andykarpov/karabas-esplay/docs/karabas-esplay-revA-bottom.png

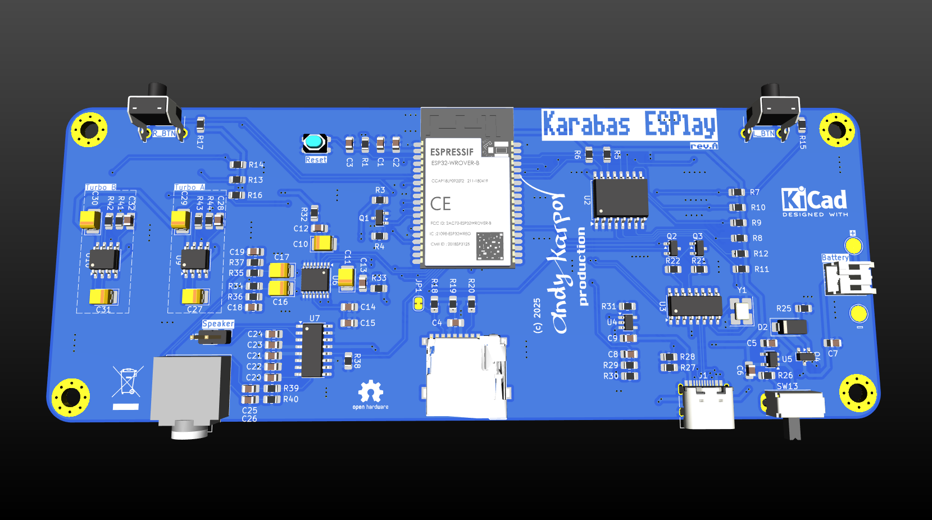
docs/karabas-esplay-revA-bottom.png
