andykarpov/karabas-esplay/README.md

# Karabas ESPlay

A derivative pcb for the ESPlay micro project.

## Key differences:

- A bigger 3.2" ILI9341 display
- Silicone buttons
- Turbo buttons (C and D)

## Credits and license

This board is derived from [ESPlay micro](https://github.com/pebri86/esplay_micro_hardware) by Fuji Pebri. That repository has no license file, but its author [states](https://github.com/pebri86/esplay_micro_hardware/issues/8) that the project is open source and free to modify and build upon, and asks to share modified versions.

The changes made in this repository are released under the MIT License, see [LICENSE](LICENSE). Rights in the original design remain with its author.
