andykarpov/karabas-esplay/docs/karabas-esplay-revA-top.png

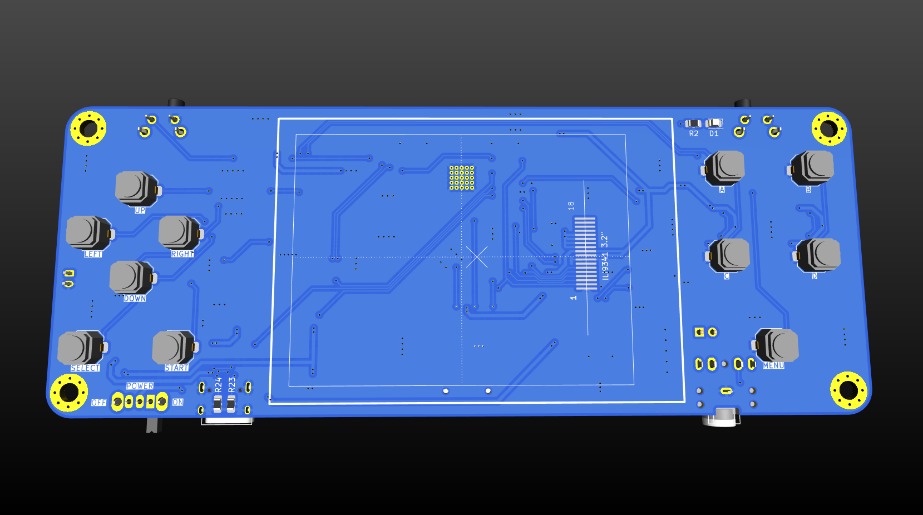
docs/karabas-esplay-revA-top.png
