andykarpov/karabas-esplay/docs/karabas-esplay-revA.pdf

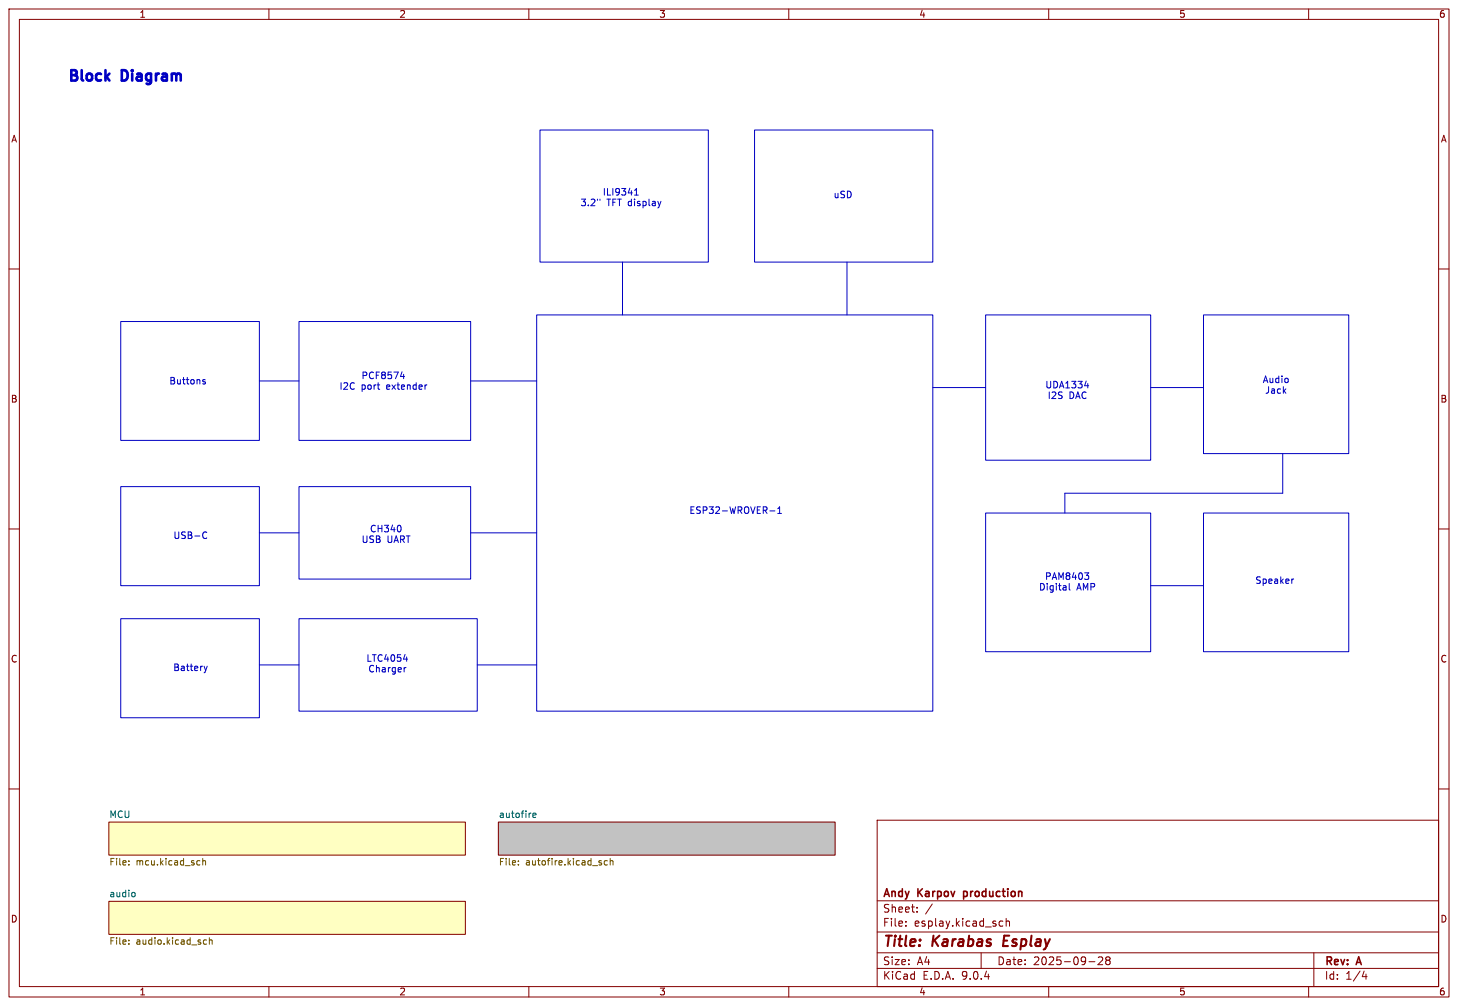
[picture p3: page 1]

audio File: audio.kicad_sch MCU

Id: 1/4 Title: Karabas Esplay

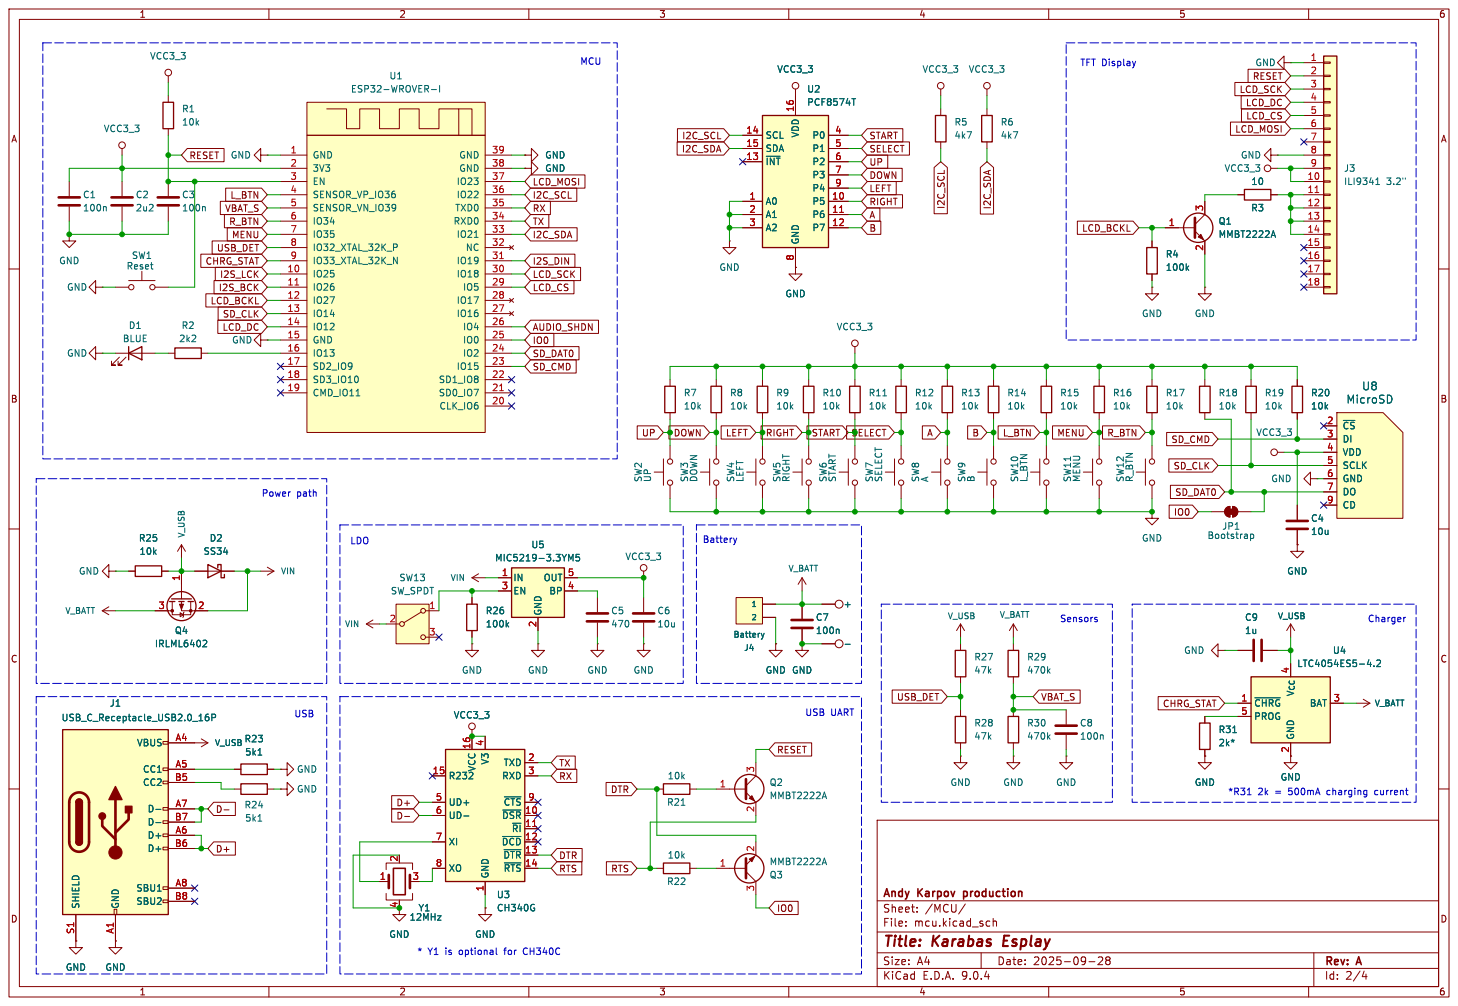
[picture p4: page 2]

~{CS} 2 DI 3 VDD 4 SCLK 5 GND 6 DO 7 CD 9U4

2 OUT 5 BP 4 U5 MIC5219-3.3YM5 GND GND

1 TXD 2 RXD 3 ~{CTS}9 ~{DSR} 10 ~{RI} 11 ~{DCD} 12 ~{DTR} 13 ~{RTS} 14 VCC3_3

1 TXD 2 RXD 3 ~{CTS}9 ~{DSR} 10 ~{RI} 11 ~{DCD} 12 ~{DTR} 13 ~{RTS} 14 U3 CH340G

Id: 2/4 Title: Karabas Esplay

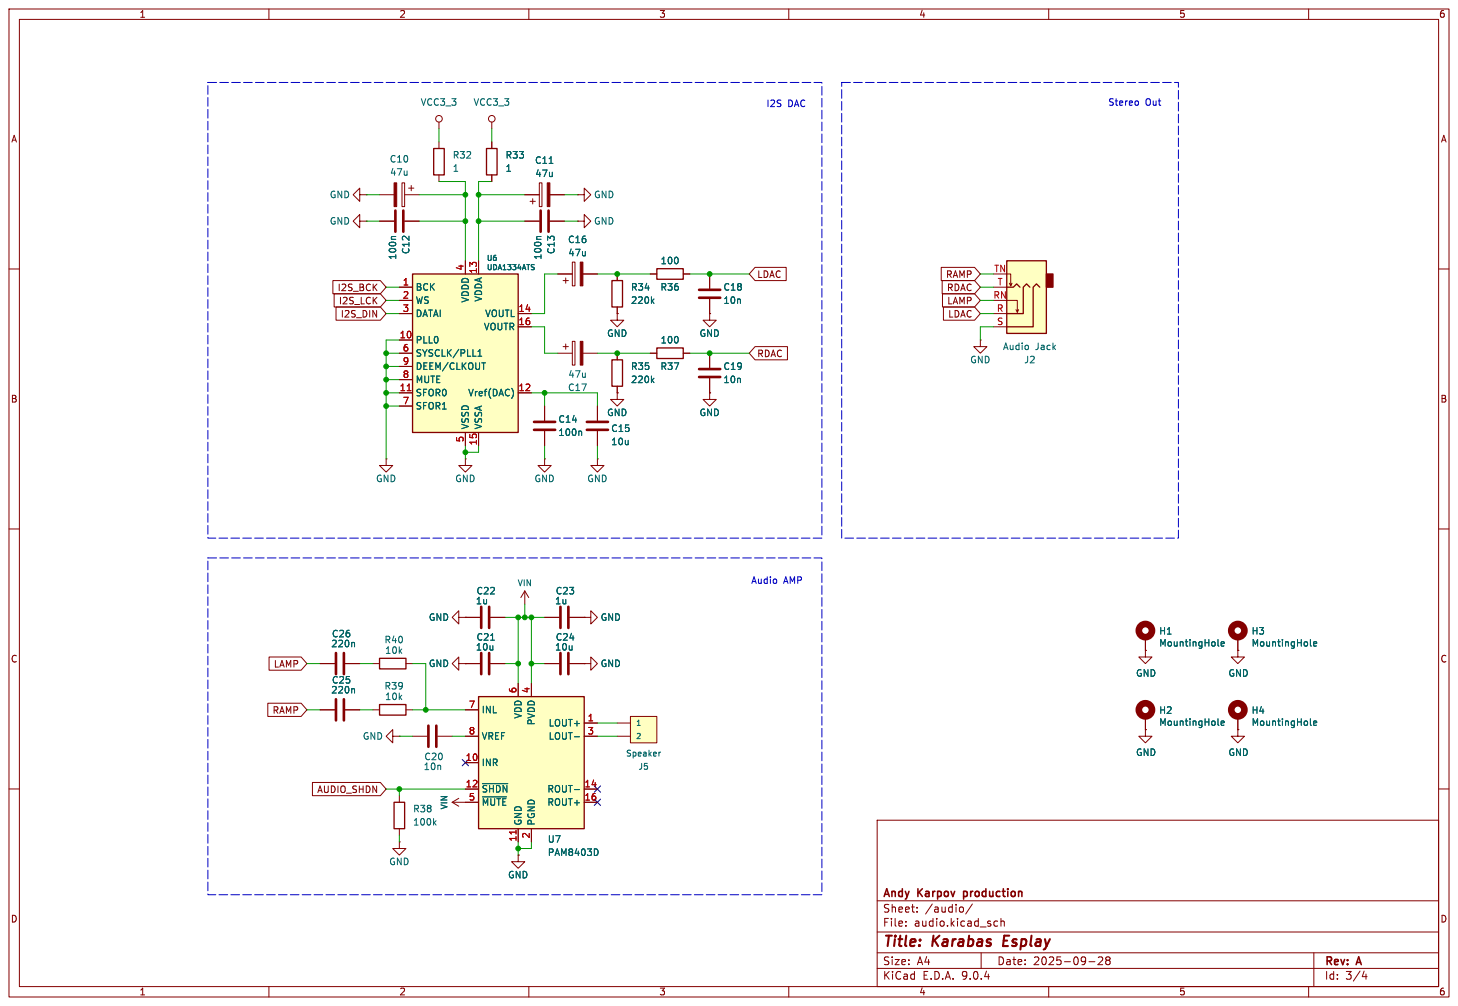
[picture p5: page 3]

5 VDDA 13 VSSA 15 VOUTL 14 VOUTR 16 Vref(DAC) 12 U6 UDA1334ATS GND GND GND

5 VDDA 13 VSSA 15 VOUTL 14 VOUTR 16 Vref(DAC) 12 C15

Id: 3/4 Title: Karabas Esplay

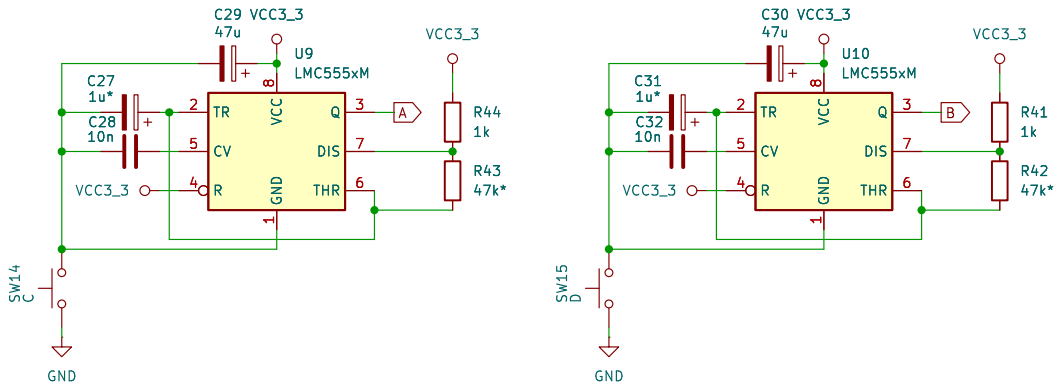
[picture p6: page 4]

Id: 4/4 Title: Karabas Esplay
