andykarpov/karabas-esplay/esplay.kicad_pcb

## KiCad design esplay.kicad_pcb (2025-10-04)

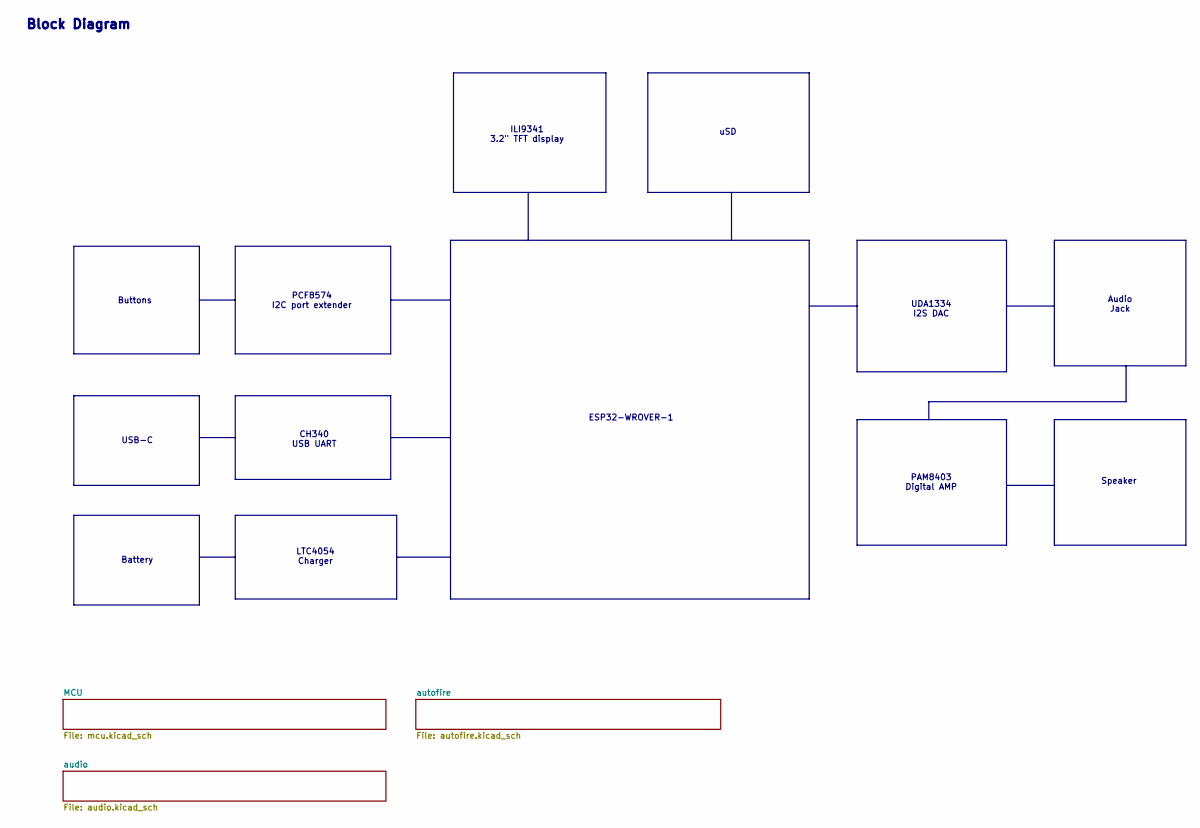
[picture p7: schematic esplay.kicad_sch, Karabas Esplay]

Notes on the sheet:
Block Diagram
PCF8574 I2C port extender
Audio Jack
uSD
Battery
LTC4054 Charger
UDA1334 I2S DAC
CH340 USB UART
Speaker
ILI9341 3.2" TFT display
Buttons
ESP32-WROVER-1
PAM8403 Digital AMP
USB-C

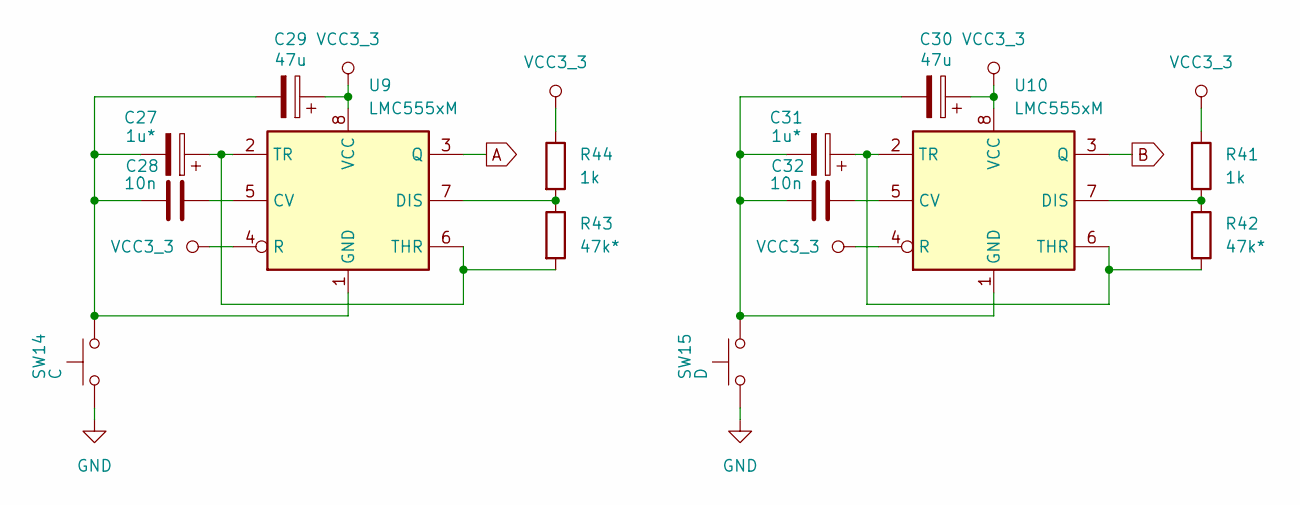
[picture p8: schematic autofire.kicad_sch, Karabas Esplay]

Parts:
C27, C31: 1u*; CP_EIA-3528-21_Kemet-B_HandSolder
C28, C32: 10n; C_0805_2012Metric_Pad1.18x1.45mm_HandSolder
C29, C30: 47u; CP_EIA-3528-21_Kemet-B_HandSolder
R41, R44: 1k; R_0805_2012Metric_Pad1.20x1.40mm_HandSolder
R42, R43: 47k*; R_0805_2012Metric_Pad1.20x1.40mm_HandSolder
SW14: C; SW_Push_1TS009_combined1
SW15: D; SW_Push_1TS009_combined1
U9, U10: LMC555xM; SOIC-8_3.9x4.9mm_P1.27mm

Connections:
A: U9.3 (Q); also elsewhere on the board
B: U10.3 (Q); also elsewhere on the board
GND: SW14.1, SW15.1; also elsewhere on the board
unnamed: C28.2, U9.5 (CV)
unnamed: R43.1, R44.2, U9.7 (DIS)
unnamed: C27.2, C28.1, C29.2, SW14.2, U9.1 (GND)
unnamed: C27.1, R43.2, U9.2 (TR), U9.6 (THR)
unnamed: C32.2, U10.5 (CV)
unnamed: R41.2, R42.1, U10.7 (DIS)
unnamed: C30.2, C31.2, C32.1, SW15.2, U10.1 (GND)
unnamed: C31.1, R42.2, U10.2 (TR), U10.6 (THR)
VCC3_3: C29.1, C30.1, R41.1, R44.1, U9.4 (R), U9.8 (VCC), U10.4 (R), U10.8 (VCC); also elsewhere on the board

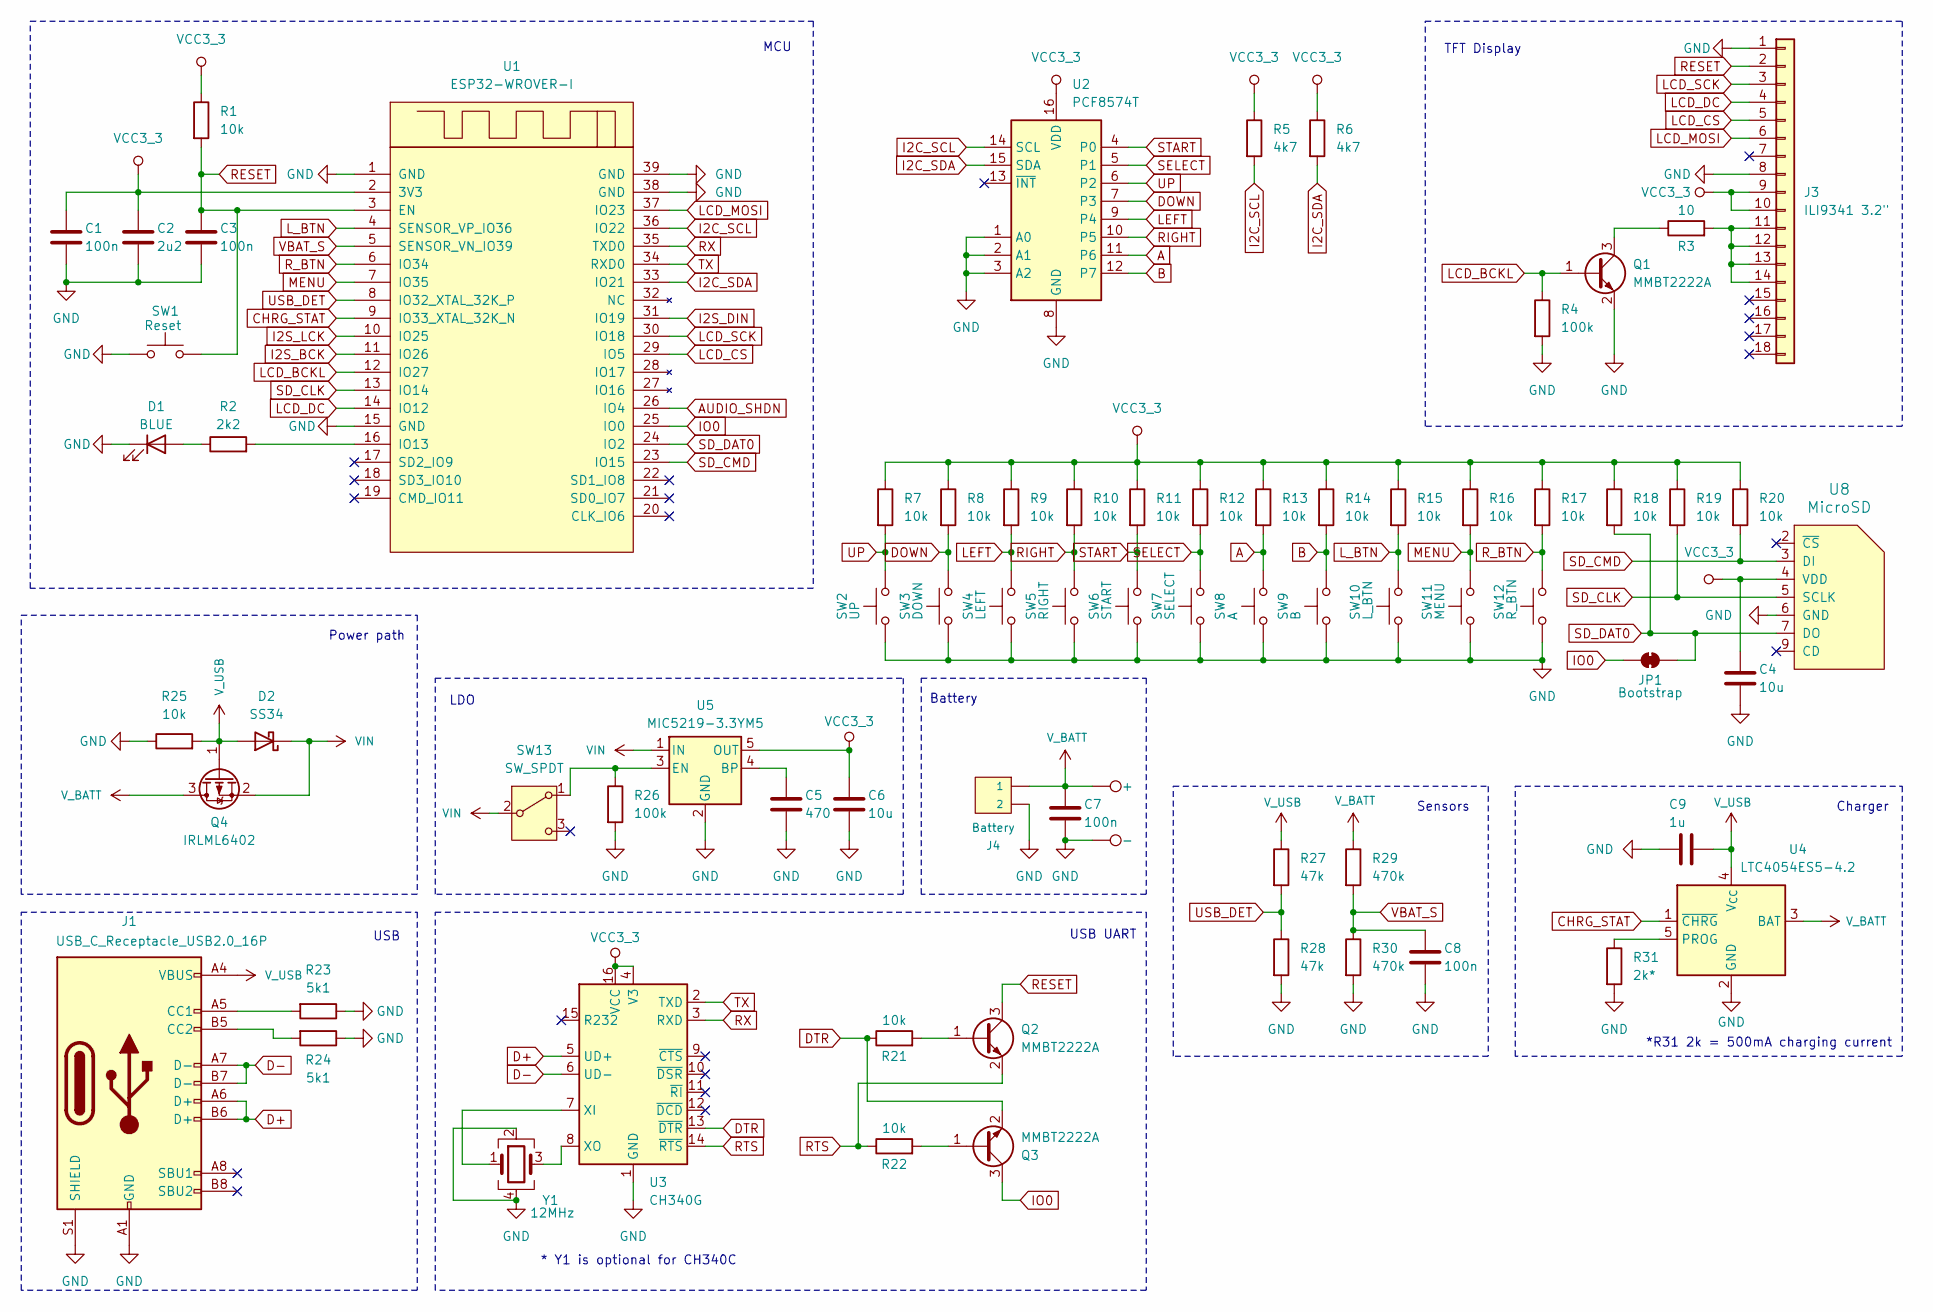
[picture p9: schematic mcu.kicad_sch, Karabas Esplay]

Parts:
BAT+1: +; TestPoint_Pad_D3.0mm
BAT-1: -; TestPoint_Pad_D3.0mm
C1, C3, C7, C8: 100n; C_0805_2012Metric_Pad1.18x1.45mm_HandSolder
C2: 2u2; C_0805_2012Metric_Pad1.18x1.45mm_HandSolder
C4, C6: 10u; C_0805_2012Metric_Pad1.18x1.45mm_HandSolder
C5: 470; C_0805_2012Metric_Pad1.18x1.45mm_HandSolder
C9: 1u; C_0805_2012Metric_Pad1.18x1.45mm_HandSolder
D1: BLUE; LED_0805_2012Metric_Pad1.15x1.40mm_HandSolder
D2: SS34; D_SMA
J1: USB_C_Receptacle_USB2.0_16P; USB_C_Receptacle_HRO_TYPE-C-31-M-12
J3: ILI9341 3.2"; TFT-ILI9341-3.2
J4: Battery; JST_PH_S2B-PH-K_1x02_P2.00mm_Horizontal
JP1: Bootstrap; SolderJumper-2_P1.3mm_Bridged_RoundedPad1.0x1.5mm
Q1, Q2, Q3: MMBT2222A; SOT-23
Q4: IRLML6402; SOT-23
R1, R7, R8, R9, R10, R11, R12, R13, R14, R15, R16, R17, R18, R19, R20, R21, R22, R25: 10k; R_0805_2012Metric_Pad1.20x1.40mm_HandSolder
R2: 2k2; R_0805_2012Metric_Pad1.20x1.40mm_HandSolder
R3: 10; R_0805_2012Metric_Pad1.20x1.40mm_HandSolder
R4, R26: 100k; R_0805_2012Metric_Pad1.20x1.40mm_HandSolder
R5, R6: 4k7; R_0805_2012Metric_Pad1.20x1.40mm_HandSolder
R23, R24: 5k1; R_0805_2012Metric_Pad1.20x1.40mm_HandSolder
R27, R28: 47k; R_0805_2012Metric_Pad1.20x1.40mm_HandSolder
R29, R30: 470k; R_0805_2012Metric_Pad1.20x1.40mm_HandSolder
R31: 2k*; R_0805_2012Metric_Pad1.20x1.40mm_HandSolder
SW1: Reset; SW_SPST_PTS810_handsoldering
SW2: UP; SW_Push_1TS009_combined1
SW3: DOWN; SW_Push_1TS009_combined1
SW4: LEFT; SW_Push_1TS009_combined1
SW5: RIGHT; SW_Push_1TS009_combined1
SW6: START; SW_Push_1TS009_combined1
SW7: SELECT; SW_Push_1TS009_combined1
SW8: A; SW_Push_1TS009_combined1
SW9: B; SW_Push_1TS009_combined1
SW10: L_BTN; SW_Tactile_SPST_Angled_PTS645Vx58-2LFS
SW11: MENU; SW_Push_1TS009_combined1
SW12: R_BTN; SW_Tactile_SPST_Angled_PTS645Vx58-2LFS
SW13: SW_SPDT; SW_Slide_SPDT_Angled_CK_OS102011MA1Q
U1: ESP32-WROVER-I; ESP32-WROVER
U2: PCF8574T; SOIC-16W_7.5x10.3mm_P1.27mm
U3: CH340G; SOIC-16_3.9x9.9mm_P1.27mm
U4: LTC4054ES5-4.2; TSOT-23-5
U5: MIC5219-3.3YM5; SOT-23-5
U8: MicroSD; GCT-MEM2055-00-190-01-A
Y1: 12MHz; Crystal_SMD_3225-4Pin_3.2x2.5mm_HandSoldering

Connections:
A: R13.2, SW8.2, U2.11 (P6); also elsewhere on the board
AUDIO_SHDN: U1.26 (IO4); also elsewhere on the board
B: R14.2, SW9.2, U2.12 (P7); also elsewhere on the board
CHRG_STAT: U1.9 (IO33_XTAL_32K_N), U4.1 (~CHRG)
D+: J1.A6 (D+), J1.B6 (D+), U3.5 (UD+)
D-: J1.A7 (D-), J1.B7 (D-), U3.6 (UD-)
DOWN: R8.2, SW3.2, U2.7 (P3)
DTR: Q3.2 (E), R21.1, U3.13 (~DTR)
GND: BAT-1.1, C1.2, C2.2, C3.2, C4.2, C5.2, C6.2, C7.2, C8.2, C9.1, D1.1 (K), J1.A1 (GND), J1.A12 (GND), J1.B1 (GND), J1.B12 (GND), J1.S1 (SHIELD), J3.1, J3.8, J4.2, Q1.2 (E), R4.2, R23.1, R24.1, R25.1, R26.2, R28.2, R30.2, R31.2, SW1.1, SW2.1, SW3.1, SW4.1, SW5.1, SW6.1, SW7.1, SW8.1, SW9.1, SW10.1, SW11.1, SW12.1, U1.1 (GND), U1.15 (GND), U1.38 (GND), U1.39 (GND), U2.1 (A0), U2.2 (A1), U2.3 (A2), U2.8 (GND), U3.1 (GND), U4.2 (GND), U5.2 (GND), U8.6 (GND), Y1.2, Y1.4; also elsewhere on the board
I2C_SCL: R5.2, U1.36 (IO22), U2.14 (SCL)
I2C_SDA: R6.2, U1.33 (IO21), U2.15 (SDA)
I2S_BCK: U1.11 (IO26); also elsewhere on the board
I2S_DIN: U1.31 (IO19); also elsewhere on the board
I2S_LCK: U1.10 (IO25); also elsewhere on the board
IO0: JP1.1 (A), Q3.3 (C), U1.25 (IO0)
LCD_BCKL: Q1.1 (B), R4.1, U1.12 (IO27)
LCD_CS: J3.5, U1.29 (IO5)
LCD_DC: J3.4, U1.14 (IO12)
LCD_MOSI: J3.6, U1.37 (IO23)
LCD_SCK: J3.3, U1.30 (IO18)
LEFT: R9.2, SW4.2, U2.9 (P4)
L_BTN: R15.2, SW10.2, U1.4 (SENSOR_VP_IO36)
MENU: R16.2, SW11.2, U1.7 (IO35)
unnamed: D1.2 (A), R2.1
unnamed: J1.A5 (CC1), R23.2
unnamed: J1.B5 (CC2), R24.2
unnamed: J3.11, J3.12, J3.13, J3.14, R3.2
unnamed: Q1.3 (C), R3.1
unnamed: Q2.1 (B), R21.2
unnamed: Q3.1 (B), R22.2
unnamed: R26.1, SW13.1 (A), U5.3 (EN)
unnamed: R2.2, U1.16 (IO13)
unnamed: U3.7 (XI), Y1.1
unnamed: U3.8 (XO), Y1.3
unnamed: R31.1, U4.5 (PROG)
unnamed: C5.1, U5.4 (BP)
RESET: C3.1, J3.2, Q2.3 (C), R1.2, SW1.2, U1.3 (EN)
RIGHT: R10.2, SW5.2, U2.10 (P5)
RTS: Q2.2 (E), R22.1, U3.14 (~RTS)
RX: U1.35 (TXD0), U3.3 (RXD)
R_BTN: R17.2, SW12.2, U1.6 (IO34)
SD_CLK: R19.2, U1.13 (IO14), U8.5 (SCLK)
SD_CMD: R20.2, U1.23 (IO15), U8.3 (DI)
SD_DAT0: JP1.2 (B), R18.2, U1.24 (IO2), U8.7 (DO)
SELECT: R12.2, SW7.2, U2.5 (P1)
START: R11.2, SW6.2, U2.4 (P0)
TX: U1.34 (RXD0), U3.2 (TXD)
UP: R7.2, SW2.2, U2.6 (P2)
USB_DET: R27.2, R28.1, U1.8 (IO32_XTAL_32K_P)
VBAT_S: C8.1, R29.2, R30.1, U1.5 (SENSOR_VN_IO39)
VCC3_3: C1.1, C2.1, C4.1, C6.1, J3.9, J3.10, R1.1, R5.1, R6.1, R7.1, R8.1, R9.1, R10.1, R11.1, R12.1, R13.1, R14.1, R15.1, R16.1, R17.1, R18.1, R19.1, R20.1, U1.2 (3V3), U2.16 (VDD), U3.4 (V3), U3.16 (VCC), U5.5 (OUT), U8.4 (VDD); also elsewhere on the board
VIN: D2.1 (K), Q4.2 (S), SW13.2 (B), U5.1 (IN); also elsewhere on the board
V_BATT: BAT+1.1, C7.1, J4.1, Q4.3 (D), R29.1, U4.3 (BAT)
V_USB: C9.2, D2.2 (A), J1.A4 (VBUS), J1.A9 (VBUS), J1.B4 (VBUS), J1.B9 (VBUS), Q4.1 (G), R25.2, R27.1, U4.4 (V_{CC})

Notes on the sheet:
*R31 2k = 500mA charging current
TFT Display
USB UART
USB
LDO
Charger
MCU
Battery
Sensors
* Y1 is optional for CH340C
Power path

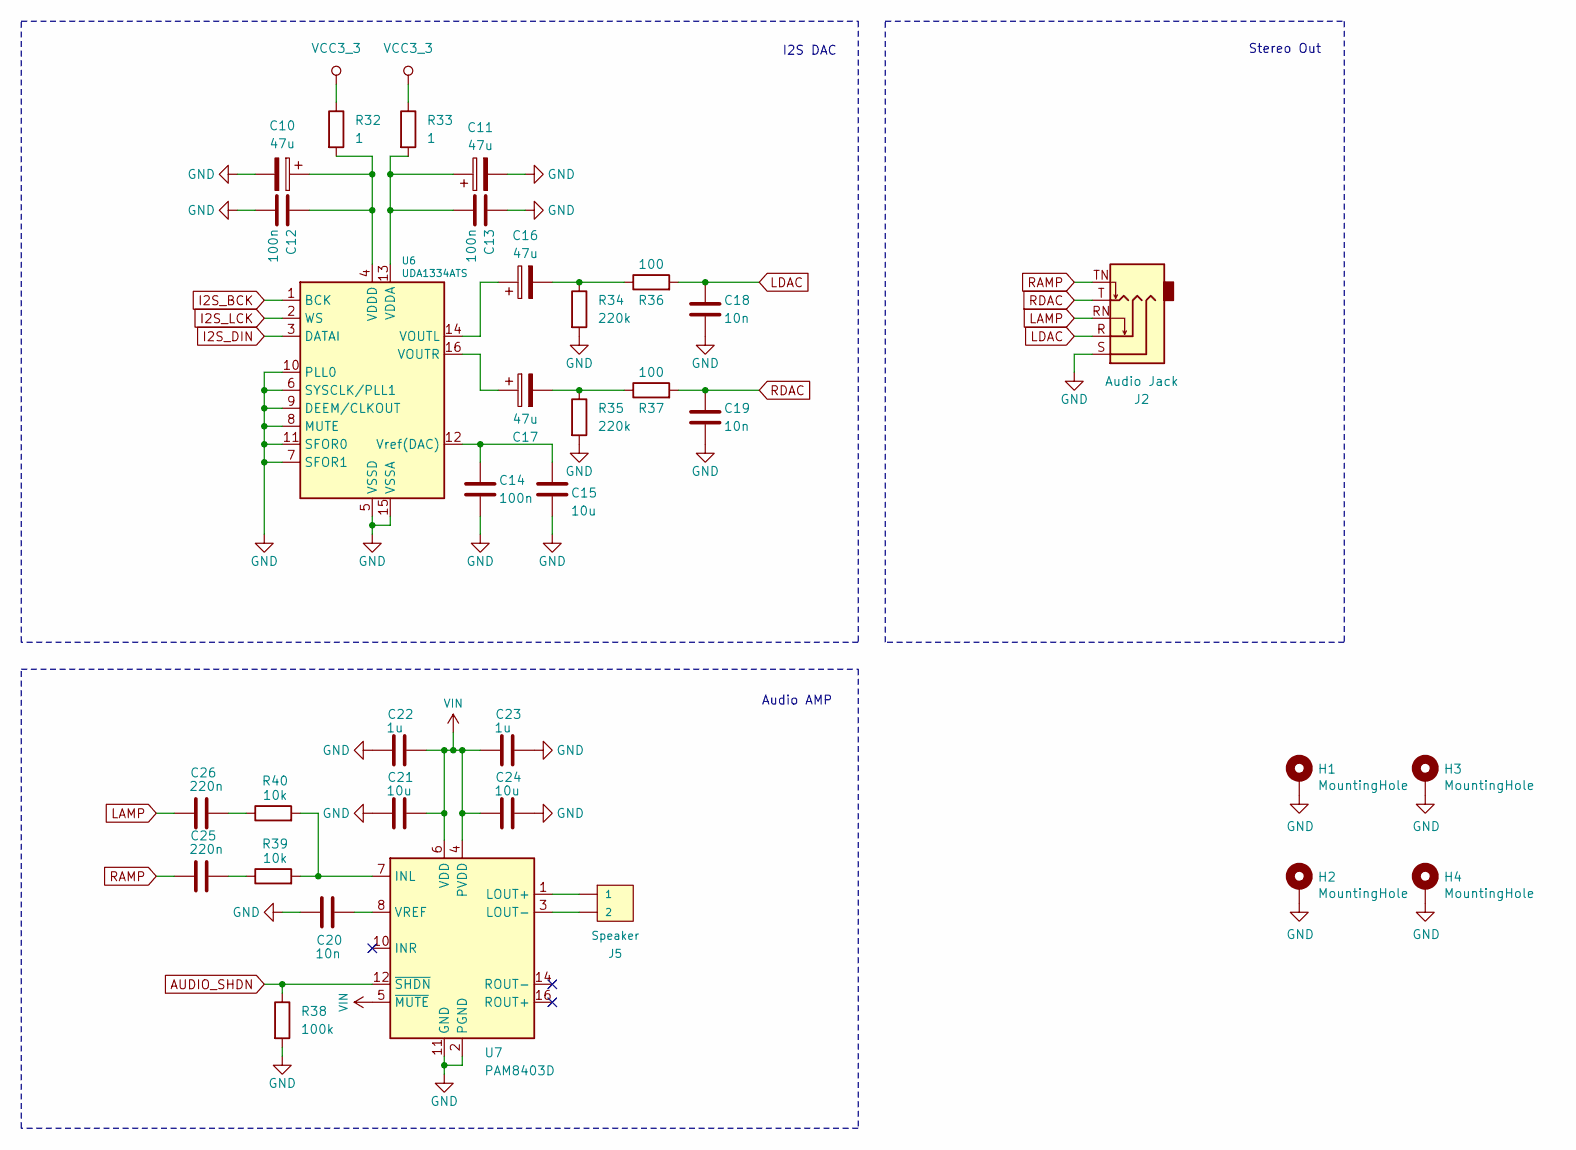
[picture p10: schematic audio.kicad_sch, Karabas Esplay]

Parts:
C10, C11, C16, C17: 47u; CP_EIA-3528-21_Kemet-B_HandSolder
C12, C13, C14: 100n; C_0805_2012Metric_Pad1.18x1.45mm_HandSolder
C15, C21, C24: 10u; C_0805_2012Metric_Pad1.18x1.45mm_HandSolder
C18, C19, C20: 10n; C_0805_2012Metric_Pad1.18x1.45mm_HandSolder
C22, C23: 1u; C_0805_2012Metric_Pad1.18x1.45mm_HandSolder
C25, C26: 220n; C_0805_2012Metric_Pad1.18x1.45mm_HandSolder
H1, H2, H3, H4: MountingHole; MountingHole_3.5mm_Pad_Via
J2: Audio Jack; Jack_3.5mm_CUI_SJ1-3525N_Horizontal
J5: Speaker; PinHeader_1x02_P2.54mm_Vertical
R32, R33: 1; R_0805_2012Metric_Pad1.20x1.40mm_HandSolder
R34, R35: 220k; R_0805_2012Metric_Pad1.20x1.40mm_HandSolder
R36, R37: 100; R_0805_2012Metric_Pad1.20x1.40mm_HandSolder
R38: 100k; R_0805_2012Metric_Pad1.20x1.40mm_HandSolder
R39, R40: 10k; R_0805_2012Metric_Pad1.20x1.40mm_HandSolder
U6: UDA1334ATS; SSOP-16_4.4x5.2mm_P0.65mm-extended
U7: PAM8403D; SOIC-16_3.9x9.9mm_P1.27mm

Connections:
AUDIO_SHDN: R38.1, U7.12 (~SHDN); also elsewhere on the board
GND: C10.2, C11.2, C12.2, C13.1, C14.2, C15.2, C18.2, C19.2, C20.1, C21.1, C22.1, C23.2, C24.2, H1.1, H2.1, H3.1, H4.1, J2.S, R34.2, R35.2, R38.2, U6.5 (VSSD), U6.6 (SYSCLK/PLL1), U6.7 (SFOR1), U6.8 (MUTE), U6.9 (DEEM/CLKOUT), U6.10 (PLL0), U6.11 (SFOR0), U6.15 (VSSA), U7.2 (PGND), U7.11 (GND), U7.15 (PGND); also elsewhere on the board
I2S_BCK: U6.1 (BCK); also elsewhere on the board
I2S_DIN: U6.3 (DATAI); also elsewhere on the board
I2S_LCK: U6.2 (WS); also elsewhere on the board
LAMP: C26.2, J2.RN
LDAC: C18.1, J2.R, R36.2
unnamed: C16.2, R34.1, R36.1
unnamed: C17.2, R35.1, R37.1
unnamed: C25.1, R39.1
unnamed: C26.1, R40.1
unnamed: C11.1, C13.2, R33.2, U6.13 (VDDA)
unnamed: C10.1, C12.1, R32.2, U6.4 (VDDD)
unnamed: C16.1, U6.14 (VOUTL)
unnamed: C17.1, U6.16 (VOUTR)
unnamed: C14.1, C15.1, U6.12 (Vref(DAC))
unnamed: R39.2, R40.2, U7.7 (INL)
unnamed: J5.1, U7.1 (LOUT+)
unnamed: J5.2, U7.3 (LOUT-)
unnamed: C20.2, U7.8 (VREF)
RAMP: C25.2, J2.TN
RDAC: C19.1, J2.T, R37.2
VCC3_3: R32.1, R33.1; also elsewhere on the board
VIN: C21.2, C22.2, C23.1, C24.1, U7.4 (PVDD), U7.5 (~MUTE), U7.6 (VDD), U7.13 (PVDD); also elsewhere on the board

Notes on the sheet:
Audio AMP
I2S DAC
Stereo Out

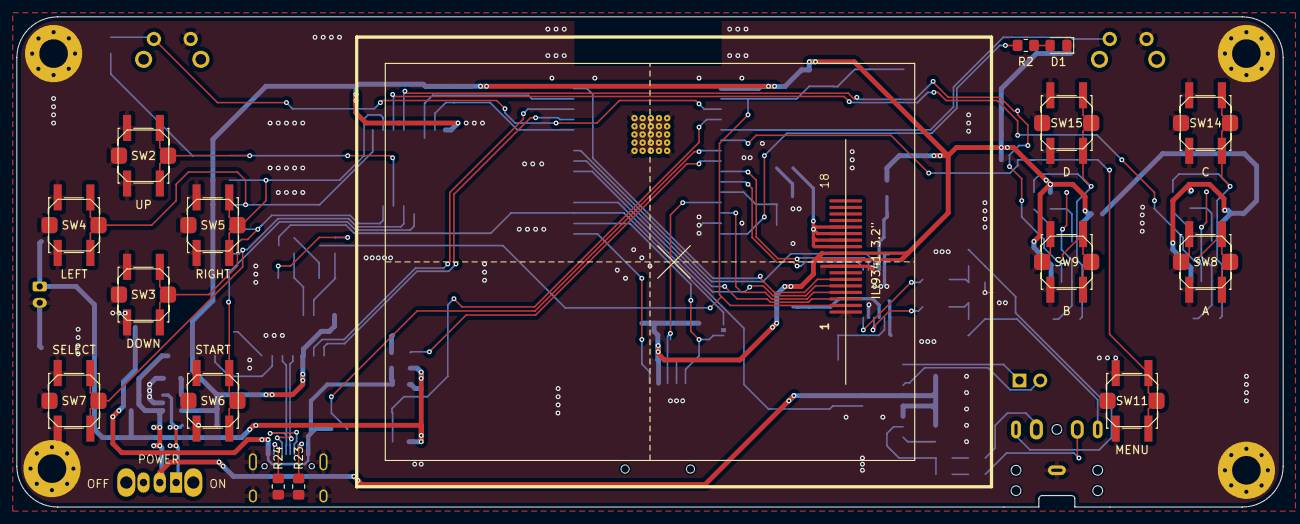
[picture p11: board esplay.kicad_pcb from above]

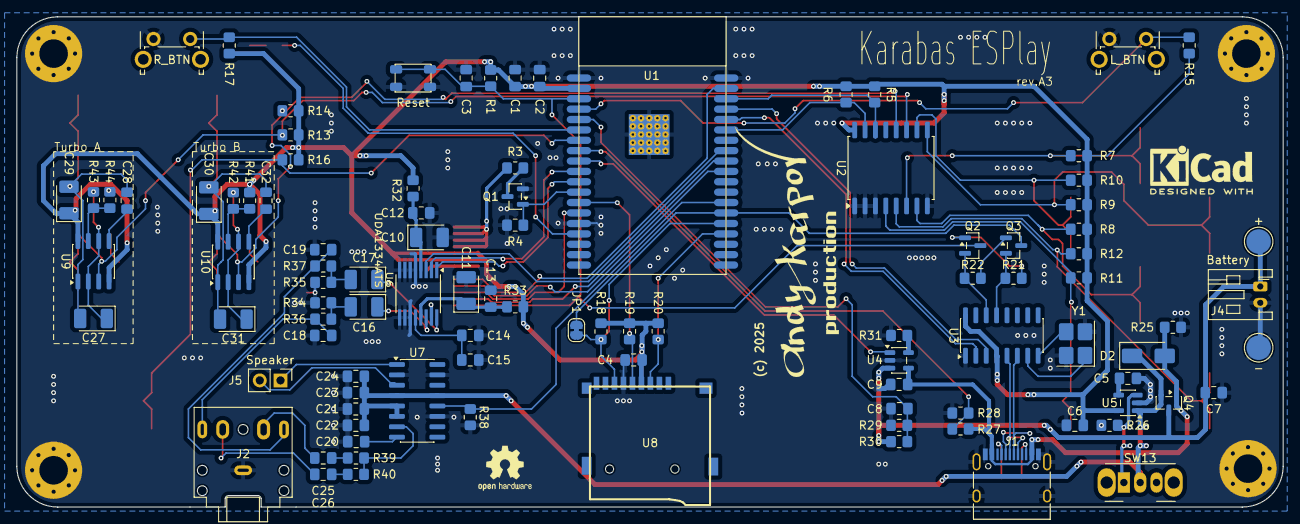
[picture p12: board esplay.kicad_pcb from below]

Board: 2 copper layers, 155.0 x 60.0 mm, 120 parts (100 on the bottom side), 79 nets.
