andykarpov/karabas-esplay/(commit log)

2025-09-29 Final revA
    [esplay.kicad_pcb, mcu.kicad_sch]
2025-09-29 added keepout area to the wifi antenna
    [esplay.kicad_pcb]
2025-09-30 Added revA2
    [audio.kicad_sch, autofire.kicad_sch, esplay.kicad_pcb, esplay.kicad_sch, mcu.kicad_sch]
